Projects-and-Stuff/Chameleon/README.md

# Chameleon #
#### A colorful RBG LED drink coaster with capacitive sensing ####

---

*File Structure*

* ./Firmware/ --> Firmware for the project (Written in C Utilizing AVR Studio 5 and AVRGCC)
* ./Hardware/ --> Kicad Project for Chameleon
* ./GerberOutput/ --> The latest Gerber Files for manufacture
* ./Notes/ --> Project Notes, BOM, and Research

---

Additional information, research, and notes can be found at http://www.projectsandstuff.com, or email us at support@projectsandstuff.com

Let us know if you fork and make improvements. We'd be glad to consider merges that improve this project.

---

Updates can be found in the Project Log, in the Notes folder

---

CURRENT AUTHORS:

> [Jack Linke](http://www.jacklinke.com)
jacklinke@gmail.com
