Projects-and-Stuff/Chameleon/Case/Case.png

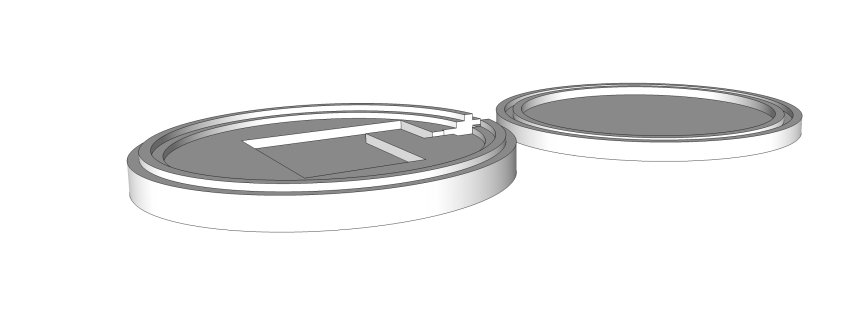
Case/Case.png
