Projects-and-Stuff/Chameleon/Notes/Chameleon BOM.xlsx

Sheet: Electronics
Bill of Materials - Chameleon Drink Coasters - Electronics |  |  |  |  |  |  |  |  |  |  | # of boards goal: | 500
Projects and Stuff LLC - http://www.projectsandstuff.com
Total BOM Parts Cost: | $4540.73 | Per Board Cost: | $9.08
Description | Mfg Part # | Package | KiCad Footprint | Default Supplier | Supplier On Hand | Qty per board | Total Qty Needed | Price per part at Qty | Price Per Board | Total Price | Notes | Part References
Capacitor Ceramic 1nF | CL10B102KB8SFNC | 0603 | GOOD | DigiKey | 80889 | 11 | 5500 | $0.00339 | $0.04 | $18.64 | Filtering for LEDs
Capacitor Ceramic 4.7nF 50V 10% | CL10B472KB8SFNC | 0603 | GOOD | DigiKey | 8836 | 2 | 1000 | $0.00618 | $0.01 | $6.18 | Used for QMatrix RY line capacitors and USB Shield Termination
Capacitor Ceramic 0.1uF 16V 10% | CL10B104KO8NNNC | 0603 | GOOD | DigiKey | 3312000 | 9 | 4500 | $0.00359 | $0.03 | $16.16 | Used for Power Input/Output filtering and Decoupling
Capacitor Ceramic 1uF 6.3V X5R | CL10B105KQ8NNNC | 0603 | GOOD | DigiKey | 408144 | 1 | 500 | $0.01310 | $0.01 | $6.55
Capacitor Ceramic 10uF 6.3V X5R | CL10A106MQ8NNNC | 0603 | GOOD | Digikey | 167415 | 3 | 1500 | $0.04650 | $0.14 | $69.75 | Input Capacitor used with Boost Regulator
Capacitor Ceramic 47uF 6.3V 20% | GRM31CR60J476ME19L | 1206 | GOOD | Digikey | 151601 | 1 | 500 | $0.19846 | $0.20 | $99.23 | Output Capacitor used with Boost Regulator
Resistor 120Ω 1/10W 5% | RC1608J121CS | 0603 | GOOD | Digikey | 9886 | 5 | 2500 | $0.00174 | $0.01 | $4.35 | Current limiting resistors for White LEDs
Resistor 1kΩ 1/10W 5% | RC0603JR-071KL | 0603 | GOOD | DigiKey | 38481 | 2 | 1000 | $0.00207 | $0.00414 | $2.07 | Used for QMatrix X&Y line resistors
Resistor 4kΩ | RC1608J392CS | 0603 | GOOD | DigiKey | 9400 | 1 | 500 | $0.00274 | $0.00274 | $1.37 | Provides Current Bias for the As1121
Resistor 10kΩ 1/10W 5% | RC1608J103CS | 0603 | GOOD | DigiKey | 3129 | 18 | 9000 | $0.00201 | $0.04 | $18.09 | Pull-up/down resistors
Resistor 100KΩ 1/10W 5% | RC0603JR-07100KL | 0603 | GOOD | DigiKey | 744323 | 2 | 1000 | $0.00207 | $0.00414 | $2.07
Resistor 300KΩ 1/10W 5% | RC0603JR-07300KL | 0603 | GOOD | DigiKey | 8889 | 1 | 500 | $0.00294 | $0.00294 | $1.47
Resistor 470KΩ 1/10W 5% | RC1608J474CS | 0603 | GOOD | DigiKey | 10000 | 1 | 500 | $0.00274 | $0.00274 | $1.37 | Used for QMatrix RY line resistors
Resistor 1.05MΩ 1/10W 1% | RC1608F1054CS | 0603 | GOOD | DigiKey | 9475 | 1 | 500 | $0.00206 | $0.00206 | $1.03 | Part of USB Shield Termination
Inductor 10uH 340mA 10% | LB3218T100K | 1207 | GOOD | DigiKey | 19931 | 1 | 500 | $0.08526 | $0.09 | $42.63 | Input Filtering for uC Power
Inductor 33uH 10% | LB3218T330K | 1207 | GOOD | DigiKey | 3051 | 1 | 500 | $0.08526 | $0.09 | $42.63 | Used with Boost Regulator Input
Ferrite Bead | BK0603HS330-T | 0603 | GOOD | Digikey | 22721 | 1 | 500 | $0.04554 | $0.05 | $22.77 | Analog Input filtering for uC
PLCC-6 RGB LED |  | 5.0mm x 5.0mm | G | Alibaba |  | 5 | 2500 | $0.03300 | $0.17 | $82.50 | LED Lighting
LED White |  | 0603 | G | AliExpress |  | 5 | 2500 | $0.03000 | $0.15 | $75.00 | White LED Lighting
LED Red Diffused | LS L29K-G1J2-1-Z | 0603 | GOOD | DigiKey | 63971 | 1 | 500 | $0.09140 | $0.09 | $45.70 | Power/Status Indicator
Diode Schottky 10V 0.57A | ZLLS410TA | SOT-23-3 | GOOD | Digikey | 34988 | 2 | 1000 | $0.12328 | $0.25 | $123.28 | Used with Boost Regulator and Latching Power Block
MOSFET N & P Pair | SI3588DV-T1-E3 | 6-TSOP | GOOD | Mouser | 3000 | 1 | 500 | $0.55000 | $0.55 | $275.00 | Used in Latching Power Block
Switch Tactile SPST-NO 0.05A 15V | TL3315NF160Q | 4.5mm x 4.5mm | GOOD | DigiKey | 132026 | 1 | 500 | $0.14674 | $0.15 | $73.37 | AVR Reset Switch
Switch Tactile SPST-NO 0.05A 12V | TL1105JAF160Q | 7.20mm x 7.00mm | GOOD | Digikey | 17721 | 1 | 500 | $0.31540 | $0.32 | $157.70 | Mode Select Switch
Switch Tactile SPST-NO 0.05A 12V | TL1105SPF250Q | 6.00mm x 6.00mm | GOOD | DigiKey | 12672 | 1 | 500 | $0.21850 | $0.22 | $109.25 | Power Switch
Switch Cap Round White | 1RWHT |  | GOOD | Digikey | 11252 | 2 | 1000 | $0.14490 | $0.29 | $144.90 | Cap for Power and Mode Select Switch
IC AVR XMEGA Microcontroller | ATXMEGA16A4U-AU | 44-TQFP | GOOD | Digikey | 586 | 1 | 500 | $1.59840 | $1.60 | $799.20 | Microcontroller with USB
IC Boost Regulator 5V 0.2A | NCP1402SN50T1G | 5-TSOP | GOOD | Digikey | 25844 | 1 | 500 | $0.41200 | $0.41 | $206.00 | Also available at Newark, Farnell, Avnet, Verical, etc. Used for powering LEDs
IC LDO 3.3V 0.15A | TLV71333PDBVR | SOT-23-5 | GOOD | Digikey | 3261 | 1 | 500 | $0.13260 | $0.13 | $66.30 | Provides power for digital components and White LEDs
IC LED Driver RGBA | AS1121-BQFT | 32-TQFN (5x5) | GOOD | Digikey | 990 | 1 | 500 | $1.34714 | $1.35 | $673.57
Fuse PTC 500mA | MF-FSMF050X-2 | 0603 | GOOD | Digikey | 13969 | 1 | 500 | $0.21360 | $0.21 | $106.80 | Protects USB from drawing too much current
Battery (Li-Poly 3.7V 500mAh) | JHY-303450 | 50.5mm x 34.5 mm x 3.2mm |  | Shenzhen Puchuangyuan Technology Co. Ltd |  | 1 | 500 | $1.66000 | $1.66 | $830.00 | Nominal Voltage: 3.7V
Connector Receptical USB Micro B | ZX62WRD-B-5PC | USB - Micro B | GOOD | Digikey | 4925 | 1 | 500 | $0.83160 | $0.83 | $415.80 | Water resistant USB Connector for charging and data
 |  |  |  |  |  |  | 0 |  | $0.00 | $0.00
 |  |  |  |  |  |  | 0 |  | $0.00 | $0.00
 |  |  |  |  |  |  | 0 |  | $0.00 | $0.00
 |  |  |  |  |  |  | 0 |  | $0.00 | $0.00
 |  |  |  |  |  |  | 0 |  | $0.00 | $0.00
 |  |  |  |  |  |  | 0 |  | $0.00 | $0.00
 |  |  |  |  |  |  | 0 |  | $0.00 | $0.00
 |  |  |  |  |  |  | 0 |  | $0.00 | $0.00
 |  |  |  |  |  |  | 0 |  | $0.00 | $0.00
 |  |  |  |  |  |  | 0 |  | $0.00 | $0.00
 |  |  |  |  |  |  | 0 |  | $0.00 | $0.00
 |  |  |  |  |  |  | 0 |  | $0.00 | $0.00
 |  |  |  |  |  |  | 0 |  | $0.00 | $0.00
 |  |  |  |  |  |  | 0 |  | $0.00 | $0.00
 |  |  |  |  |  |  | 0 |  | $0.00 | $0.00
 |  |  |  |  |  |  | 0 |  | $0.00 | $0.00
 |  |  |  |  |  |  | 0 |  | $0.00 | $0.00
 |  |  |  |  |  |  | 0 |  | $0.00 | $0.00
 |  |  |  |  |  |  | 0 |  | $0.00 | $0.00
 |  |  |  |  |  |  | 0 |  | $0.00 | $0.00
 |  |  |  |  |  |  | 0 |  | $0.00 | $0.00
 |  |  |  |  |  |  | 0 |  | $0.00 | $0.00
 |  |  |  |  |  |  | 0 |  | $0.00 | $0.00
 |  |  |  |  |  |  | 0 |  | $0.00 | $0.00
 |  |  |  |  |  |  | 0 |  | $0.00 | $0.00
 |  |  |  |  |  |  | 0 |  | $0.00 | $0.00
 |  |  |  |  |  |  | 0 |  | $0.00 | $0.00
 |  |  |  |  |  |  | 0 |  | $0.00 | $0.00
 |  |  |  |  |  |  | 0 |  | $0.00 | $0.00
 |  |  |  |  |  |  | 0 |  | $0.00 | $0.00
 |  |  |  |  |  |  | 0 |  | $0.00 | $0.00
 |  |  |  |  |  |  | 0 |  | $0.00 | $0.00
 |  |  |  |  |  |  | 0 |  | $0.00 | $0.00
 |  |  |  |  |  |  | 0 |  | $0.00 | $0.00
 |  |  |  |  |  |  | 0 |  | $0.00 | $0.00
 |  |  |  |  |  |  | 0 |  | $0.00 | $0.00
 |  |  |  |  |  |  | 0 |  | $0.00 | $0.00
 |  |  |  |  |  |  | 0 |  | $0.00 | $0.00
 |  |  |  |  |  |  | 0 |  | $0.00 | $0.00
 |  |  |  |  |  |  | 0 |  | $0.00 | $0.00
 |  |  |  |  |  |  | 0 |  | $0.00 | $0.00
 |  |  |  |  |  |  | 0 |  | $0.00 | $0.00
 |  |  |  |  |  |  | 0 |  | $0.00 | $0.00
 |  |  |  |  |  |  | 0 |  | $0.00 | $0.00
 |  |  |  |  |  |  | 0 |  | $0.00 | $0.00
 |  |  |  |  |  |  | 0 |  | $0.00 | $0.00
 |  |  |  |  |  |  | 0 |  | $0.00 | $0.00
 |  |  |  |  |  |  | 0 |  | $0.00 | $0.00
 |  |  |  |  |  |  | 0 |  | $0.00 | $0.00
 |  |  |  |  |  |  | 0 |  | $0.00 | $0.00
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
 |  |  |  |  |  |  | 0 |  | $0.00 | $0.00
 |  |  |  |  |  |  | 0 |  | $0.00 | $0.00
 |  |  |  |  |  |  | 0 |  | $0.00 | $0.00
 |  |  |  |  |  |  | 0 |  | $0.00 | $0.00
 |  |  |  |  |  |  | 0 |  | $0.00 | $0.00
 |  |  |  |  |  |  | 0 |  | $0.00 | $0.00
 |  |  |  |  |  |  | 0 |  | $0.00 | $0.00
 |  |  |  |  |  |  | 0 |  | $0.00 | $0.00
 |  |  |  |  |  |  | 0 |  | $0.00 | $0.00
 |  |  |  |  |  |  | 0 |  | $0.00 | $0.00
 |  |  |  |  |  |  | 0 |  | $0.00 | $0.00
 |  |  |  |  |  |  | 0 |  | $0.00 | $0.00
 |  |  |  |  |  |  | 0 |  | $0.00 | $0.00
 |  |  |  |  |  |  | 0 |  | $0.00 | $0.00
 |  |  |  |  |  |  | 0 |  | $0.00 | $0.00
 |  |  |  |  |  |  | 0 |  | $0.00 | $0.00
 |  |  |  |  |  |  | 0 |  | $0.00 | $0.00
 |  |  |  |  |  |  | 0 |  | $0.00 | $0.00
 |  |  |  |  |  |  | 0 |  | $0.00 | $0.00
 |  |  |  |  |  |  | 0 |  | $0.00 | $0.00
 |  |  |  |  |  |  | 0 |  | $0.00 | $0.00
 |  |  |  |  |  |  | 0 |  | $0.00 | $0.00

Sheet: Other
Bill of Materials - Chameleon Drink Coasters - Other |  |  |  |  |  |  |  | # of boards goal: | 1000
Projects and Stuff LLC - http://www.projectsandstuff.com
Total BOM Parts Cost: | $330.00
Description | Mfg Part # | Default Supplier | Supplier On Hand | Qty per board | Total Qty Needed | Price per part at Qty | Total Price | Notes | Part References
Indestructo Mailers | White or Kraft (http://www.uline.com/Grp_435/Indestructo-Mailers) | ULINE |  | 1 | 1000 | $0.24000 | $240.00 | (Similar also available at http://www.packagingsupplies.com/White_Corrugated_Boxes__Mailers.html - they're cheaper, but may not be enough on hand)
Plastic Case |  |  |  |  | 0 |  | $0.00
Foam Insert (D: 3.5" with battery cut-out) |  | Xingweicheng |  | 1 | 1000 | $0.09000 | $90.00
 |  |  |  |  | 0 |  | $0.00
 |  |  |  |  | 0 |  | $0.00
 |  |  |  |  | 0 |  | $0.00
 |  |  |  |  | 0 |  | $0.00
 |  |  |  |  | 0 |  | $0.00
 |  |  |  |  | 0 |  | $0.00
 |  |  |  |  | 0 |  | $0.00
 |  |  |  |  | 0 |  | $0.00
 |  |  |  |  | 0 |  | $0.00
 |  |  |  |  | 0 |  | $0.00
 |  |  |  |  | 0 |  | $0.00
 |  |  |  |  | 0 |  | $0.00
 |  |  |  |  | 0 |  | $0.00
 |  |  |  |  | 0 |  | $0.00
 |  |  |  |  | 0 |  | $0.00
 |  |  |  |  | 0 |  | $0.00
 |  |  |  |  | 0 |  | $0.00
 |  |  |  |  | 0 |  | $0.00
 |  |  |  |  | 0 |  | $0.00
 |  |  |  |  | 0 |  | $0.00
 |  |  |  |  | 0 |  | $0.00
 |  |  |  |  | 0 |  | $0.00
 |  |  |  |  | 0 |  | $0.00
 |  |  |  |  | 0 |  | $0.00
 |  |  |  |  | 0 |  | $0.00
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
 |  |  |  |  | 0 |  | $0.00
 |  |  |  |  | 0 |  | $0.00
 |  |  |  |  | 0 |  | $0.00
 |  |  |  |  | 0 |  | $0.00
 |  |  |  |  | 0 |  | $0.00
 |  |  |  |  | 0 |  | $0.00
 |  |  |  |  | 0 |  | $0.00
 |  |  |  |  | 0 |  | $0.00
 |  |  |  |  | 0 |  | $0.00
 |  |  |  |  | 0 |  | $0.00
 |  |  |  |  | 0 |  | $0.00
 |  |  |  |  | 0 |  | $0.00
 |  |  |  |  | 0 |  | $0.00
 |  |  |  |  | 0 |  | $0.00
 |  |  |  |  | 0 |  | $0.00
 |  |  |  |  | 0 |  | $0.00
