Projects-and-Stuff/Chameleon/Case/Case.stl

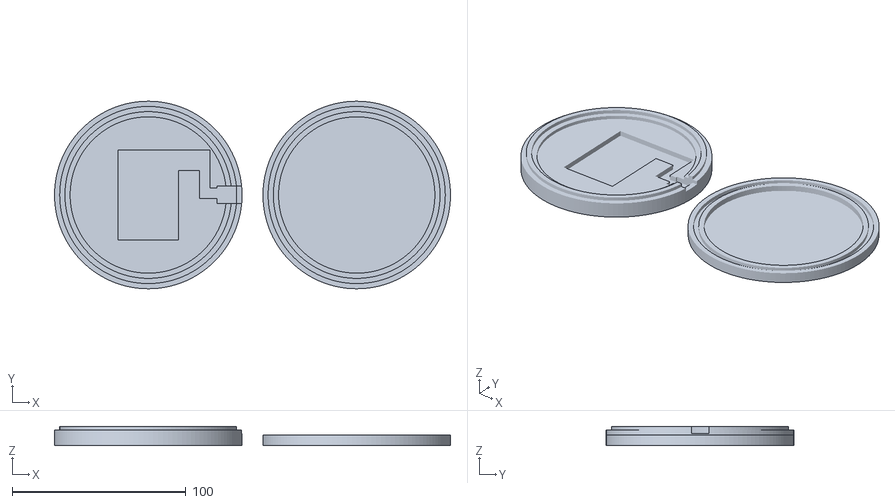
[picture p2: CAD file, 2012-12-21]
Case/Case.stl
228.0 x 108.0 x 11.0
