Projects-and-Stuff/Chameleon/(list of files, cad)

Other CAD files:
Case/Case_v (rebuilt).stl
Case/Case.skp
