Projects-and-Stuff/Chameleon/Notes/Chameleon Tutorial.docx

Projects and Stuff

Chameleon

Tutorial

# Overview and Objectives

# Assemble

## Part List

## Tools Required

## Constructing it

# Operate

# Mod

# Buy

# Discuss

Glossary
