Projects-and-Stuff/Chameleon/Hardware/Schematic.pdf

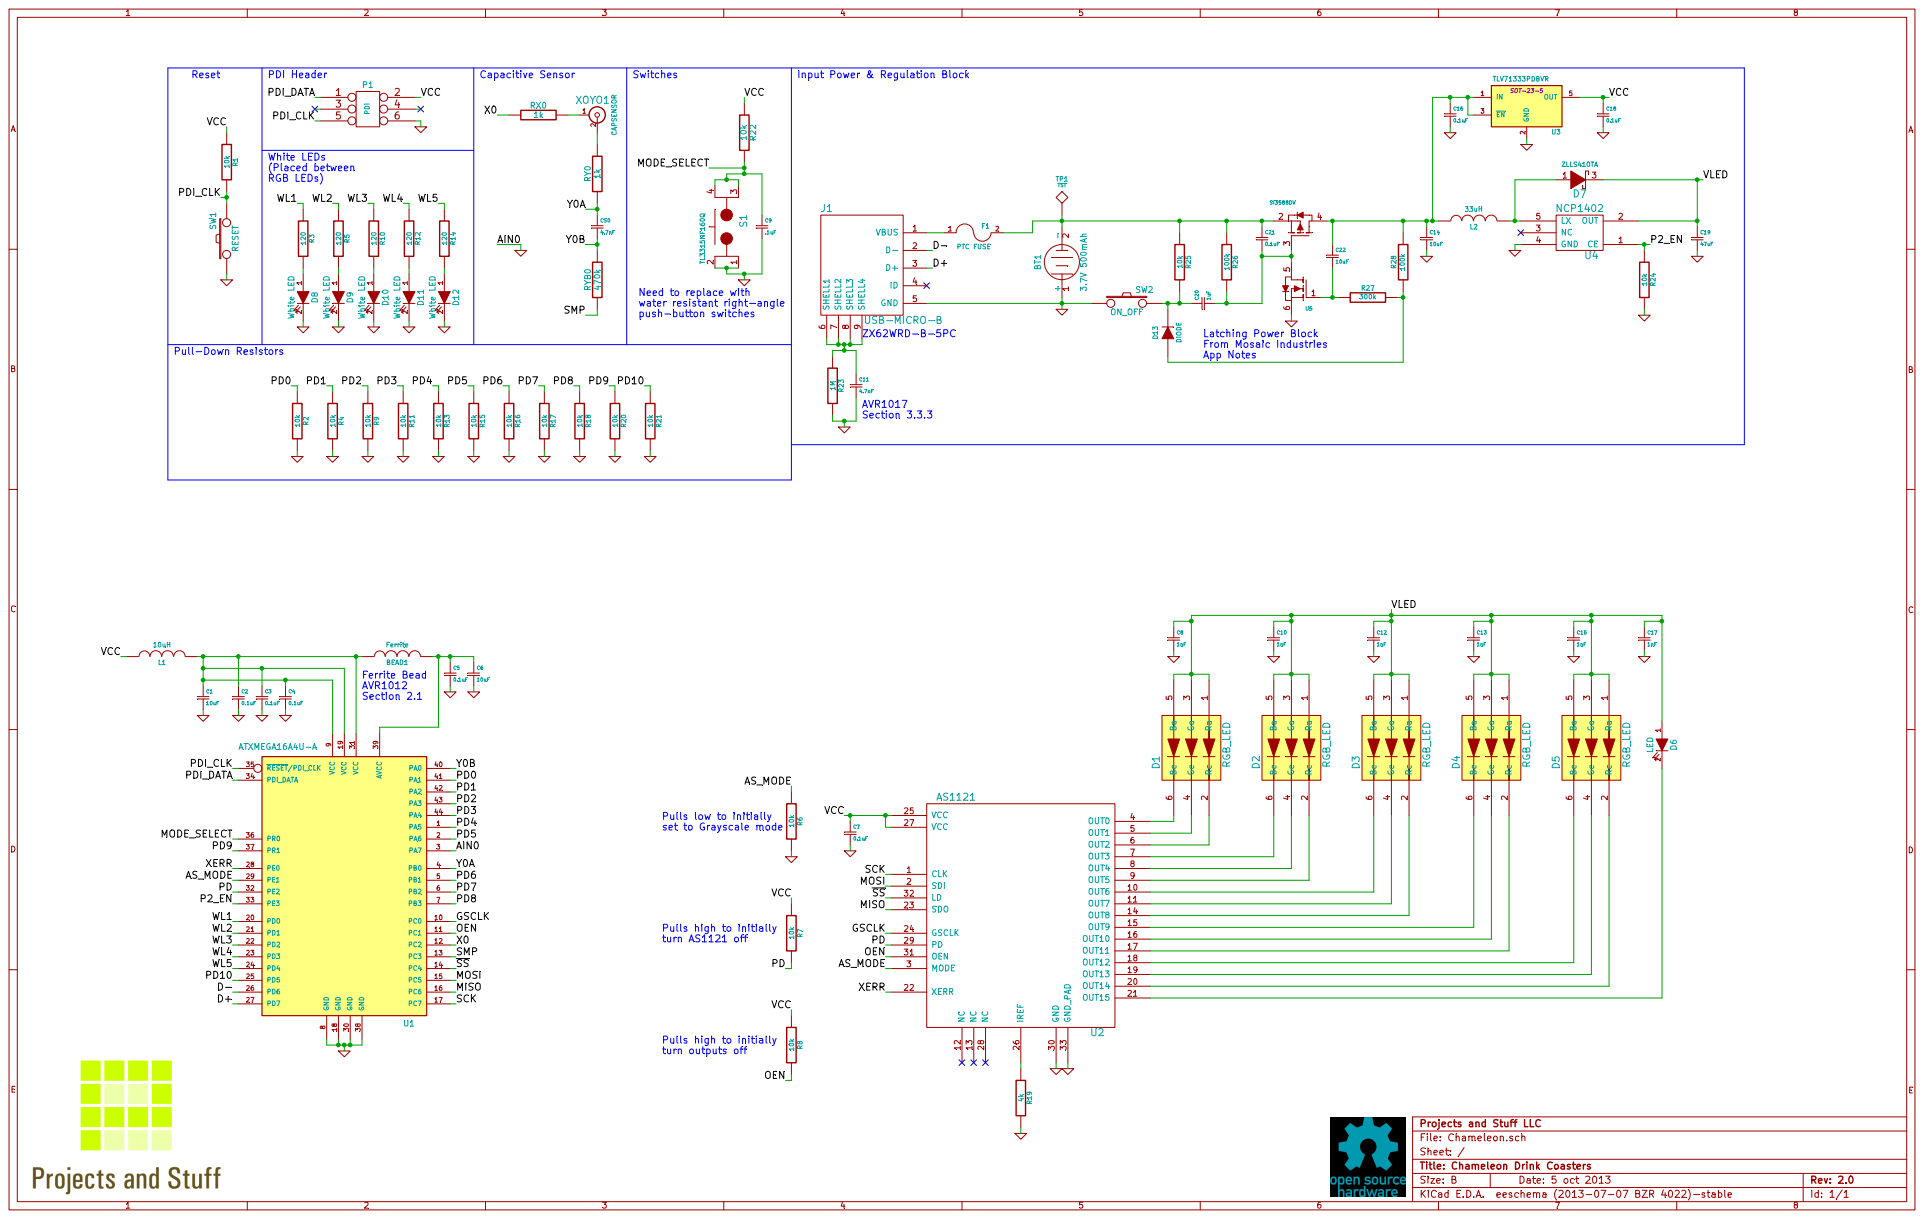
[picture p3: page 1]
