Projects-and-Stuff/Chameleon/Hardware/Back.pdf

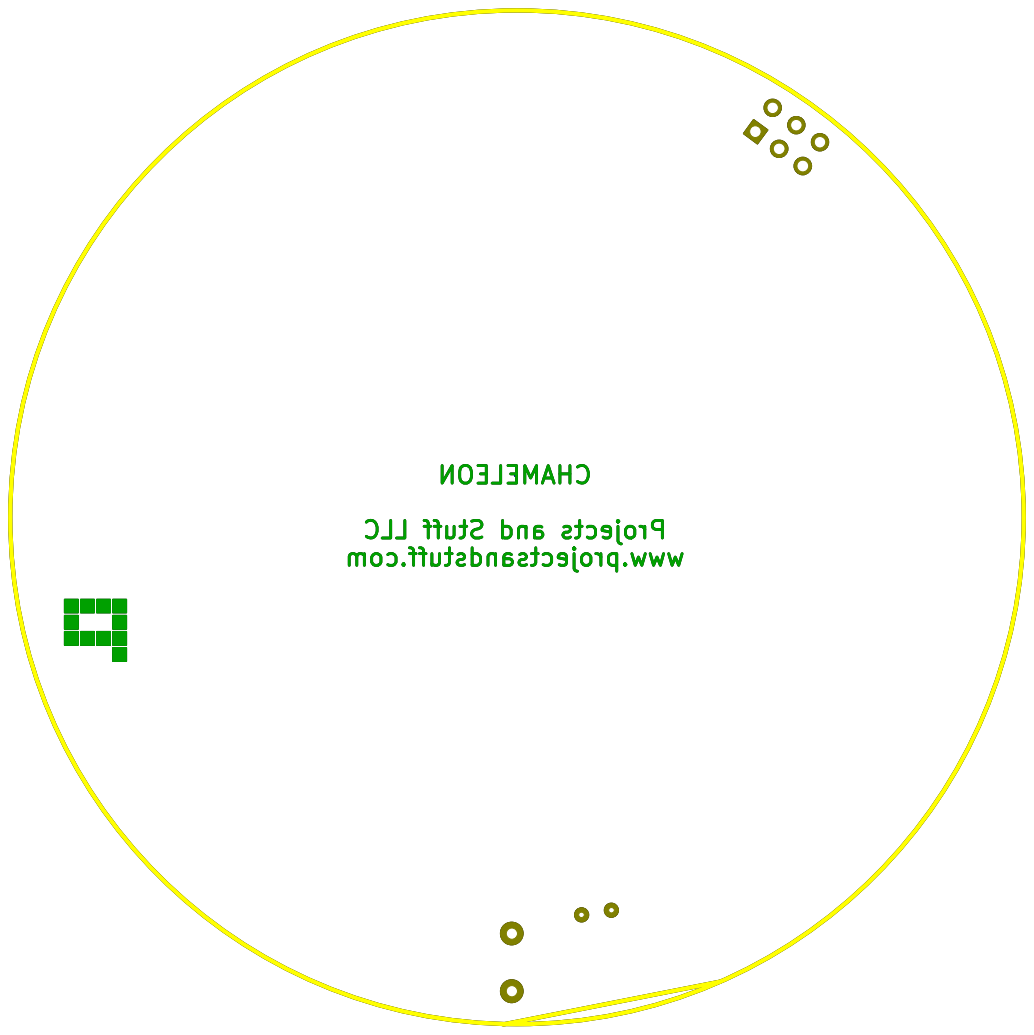
[picture p4: page 1]
