Projects-and-Stuff/Chameleon/Hardware/Front.pdf

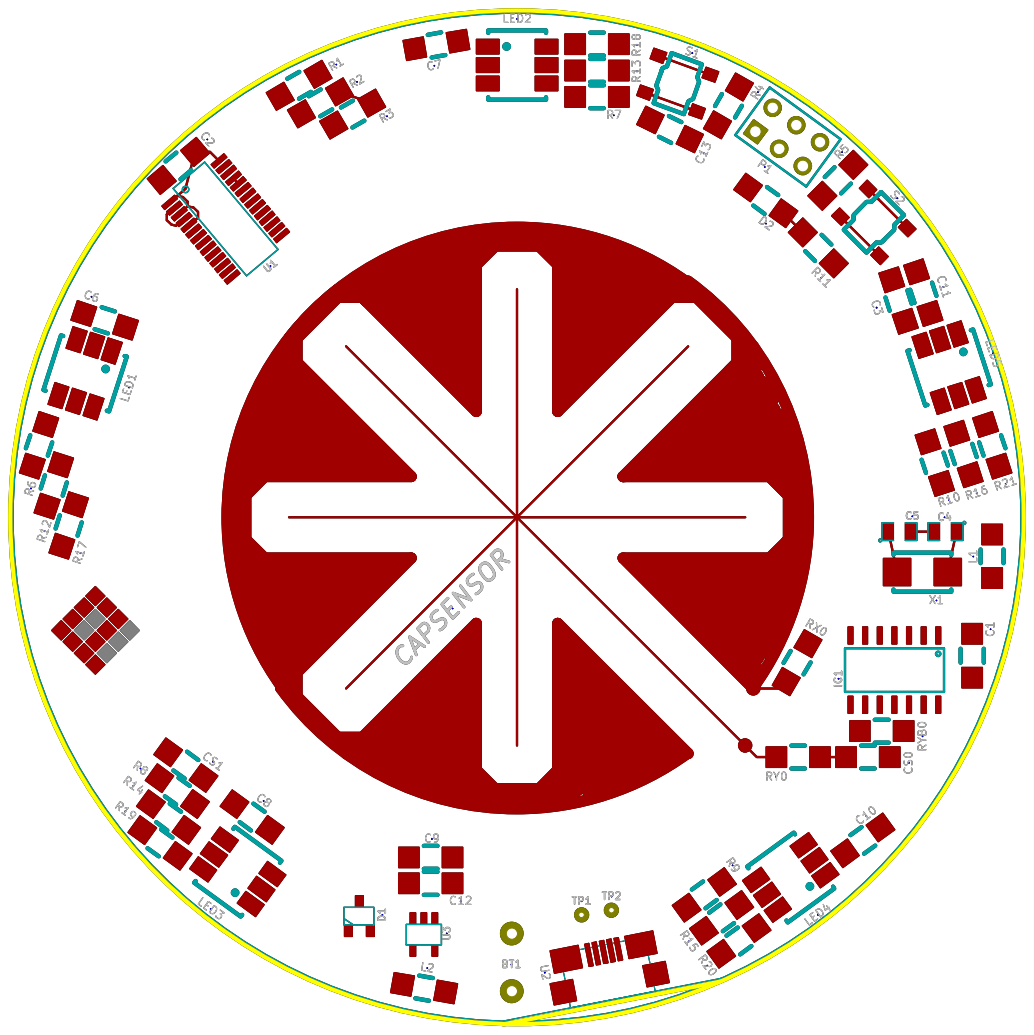
[picture p5: page 1]
