Projects-and-Stuff/Chameleon/(list of files, drawings)

Other design files:
Hardware/Chameleon.dsn
