Projects-and-Stuff/Chameleon/Hardware/Chameleon.kicad_pcb

## KiCad design Hardware/Chameleon.kicad_pcb (2013-11-11)

Schematic: Chameleon.sch, Chameleon Drink Coasters

Parts:
BEAD1: Ferrite
BT1: 3.7V 500mAh
C1, C6, C22: 10uF
C2, C3, C4, C5, C7, C16, C18, C21: 0.1uF
C8, C10, C12, C13, C15, C17: 1nF
C9: .1uF
C11: 4.7nF
C14: 10uF
C19: 47uF
C20: 1uF
CS0: 4.7nF
D1, D2, D3, D4, D5: RGB_LED
D6: LED
D7, D13: ZLLS410TA
D8, D9, D10, D11, D12: White LED
F1: PTC FUSE
IC1: ATXMEGA16A4U-A-MODIFIED; VQFN44
J1: USB-MICRO-B
L1: 10uH
L2: 33uH
P1: PDI
R1, R2, R4, R6, R7, R8, R9, R11, R13, R15, R16, R17, R18, R20, R21, R24, R25: 10k
R3, R5, R10, R12, R14: 120
R19: 4k
R22: 10k
R23: 1M
R26, R28: 100k
R27: 300k
RX0: 1k
RY0: 1k
RYB0: 470k
SW1: TL1105JAF160Q
SW2: TL1105SPF250Q
SW3: TL3315NF160Q
U2: AS1121
U3: TLV71333PDBVR; SOT-23-5
U4: NCP1402
U5: SI3588DV
XOYO1: CAPSENSOR

Connections:
/AS_MODE: IC1.29, R6.1, U2.3 (MODE)
/D+: IC1.27, J1.3 (D+)
/D-: IC1.26, J1.2 (D-)
/GSCLK: IC1.10, U2.24 (GSCLK)
/MISO: IC1.16, U2.23 (SDO)
/MODE_SELECT: C9.1, IC1.36, R22.2, SW1.2
/MOSI: IC1.15, U2.2 (SDI)
/OEN: IC1.11, R8.2, U2.31 (OEN)
/P2_EN: IC1.33, R24.1, U4.1 (CE)
/PD: IC1.32, R7.2, U2.29 (PD)
/PD0: IC1.41, R2.1
/PD1: IC1.42, R4.1
/PD2: IC1.43, R9.1
/PD3: IC1.44, R11.1
/PD4: IC1.1, R13.1
/PD5: IC1.2, R15.1
/PD6: IC1.5, R16.1
/PD7: IC1.6, R17.1
/PD8: IC1.7, R18.1
/PD9: IC1.37, R20.1
/PD10: IC1.25, R21.1
/PDI_CLK: IC1.35, P1.5, R1.2, SW3.3, SW3.4
/PDI_DATA: IC1.34, P1.1
/SCK: IC1.17, U2.1 (CLK)
/SHIELD: C11.1, J1.6 (SHELL1), J1.7 (SHELL2), J1.8 (SHELL3), J1.9 (SHELL4), R23.1
/SMP: IC1.13, RYB0.1
/VCC: C7.1, C18.1, L1.1, P1.2, R1.1, R7.1, R8.1, R22.1, U2.25 (VCC), U2.27 (VCC), U3.5 (OUT)
/VLED: C8.1, C10.1, C12.1, C13.1, C15.1, C17.1, C19.1, D1.1 (Ra), D1.3 (Ga), D1.5 (Ba), D2.1 (Ra), D2.3 (Ga), D2.5 (Ba), D3.1 (Ra), D3.3 (Ga), D3.5 (Ba), D4.1 (Ra), D4.3 (Ga), D4.5 (Ba), D5.1 (Ra), D5.3 (Ga), D5.5 (Ba), D6.1 (A), D7.2 (K), U4.2 (OUT)
/WL1: IC1.20, R3.1
/WL2: IC1.21, R5.1
/WL3: IC1.22, R10.1
/WL4: IC1.23, R12.1
/WL5: IC1.24, R14.1
/X0: IC1.12, RX0.1
/XERR: IC1.28, U2.22 (XERR)
/Y0A: CS0.1, IC1.4, RY0.1
/Y0B: CS0.2, IC1.40, RYB0.2
/~SS~: IC1.14, U2.32 (LD)
GND: BT1.1 (+), C1.2, C2.2, C3.2, C4.2, C5.2, C6.2, C7.2, C8.2, C9.2, C10.2, C11.2, C12.2, C13.2, C14.2, C15.2, C16.2, C17.2, C18.2, C19.2, D8.2 (K), D9.2 (K), D10.2 (K), D11.2 (K), D12.2 (K), IC1.3, IC1.8, IC1.18, IC1.30, IC1.38, IC1.45, J1.5 (GND), P1.6, R2.2, R4.2, R6.2, R9.2, R11.2, R13.2, R15.2, R16.2, R17.2, R18.2, R19.2, R20.2, R21.2, R23.2, R24.2, SW1.1, SW2.1, SW3.1, SW3.2, U2.30 (GND), U2.33 (GND_PAD), U3.2 (GND), U4.4 (GND), U5.6
unnamed: BEAD1.1, C1.1, C2.1, C3.1, C4.1, IC1.9, IC1.19, IC1.31, L1.2
unnamed: D5.2 (Rc), U2.20 (OUT14)
unnamed: D6.2 (K), U2.21 (OUT15)
unnamed: R19.1, U2.26 (IREF)
unnamed: D5.4 (Gc), U2.19 (OUT13)
unnamed: D1.4 (Gc), U2.5 (OUT1)
unnamed: D1.6 (Bc), U2.4 (OUT0)
unnamed: D1.2 (Rc), U2.6 (OUT2)
unnamed: D2.6 (Bc), U2.7 (OUT3)
unnamed: D2.4 (Gc), U2.8 (OUT4)
unnamed: D2.2 (Rc), U2.9 (OUT5)
unnamed: D3.6 (Bc), U2.10 (OUT6)
unnamed: D3.4 (Gc), U2.11 (OUT7)
unnamed: D3.2 (Rc), U2.14 (OUT8)
unnamed: D4.6 (Bc), U2.15 (OUT9)
unnamed: D4.4 (Gc), U2.16 (OUT10)
unnamed: D4.2 (Rc), U2.17 (OUT11)
unnamed: D5.6 (Bc), U2.18 (OUT12)
unnamed: RY0.2, XOYO1.2
unnamed: RX0.2, XOYO1.1
unnamed: D13.1 (A), R27.2, R28.1
unnamed: BT1.2 (-), C21.1, F1.2, R25.1, R26.1, U5.2
unnamed: C20.2, C21.2, R26.2, U5.3, U5.5
unnamed: C20.1, D13.2 (K), R25.2, SW2.2
unnamed: C22.2, R27.1, U5.1
unnamed: D7.1 (A), L2.2, U4.5 (LX)
unnamed: BEAD1.2, C5.1, C6.1, IC1.39
unnamed: F1.1, J1.1 (VBUS)
unnamed: D10.1 (A), R10.2
unnamed: D8.1 (A), R3.2
unnamed: D9.1 (A), R5.2
unnamed: D11.1 (A), R12.2
unnamed: D12.1 (A), R14.2
unnamed: C14.1, C16.1, C22.1, L2.1, R28.2, U3.1 (IN), U3.3 (~EN~), U5.4

Notes on the sheet:
PDI Header
Input Power & Regulation Block
Capacitive Sensor
Need to replace with water resistant right-angle push-button switches
ZX62WRD-B-5PC
Mode Select Switch
Pulls high to initially turn AS1121 off
Pulls high to initially turn outputs off
Pulls low to initially set to Grayscale mode
Reset
AVR1017 Section 3.3.3
Ferrite Bead AVR1012 Section 2.1
White LEDs (Placed between RGB LEDs)
Pull-Down Resistors
Latching Power Block From Mosaic Industries App Notes

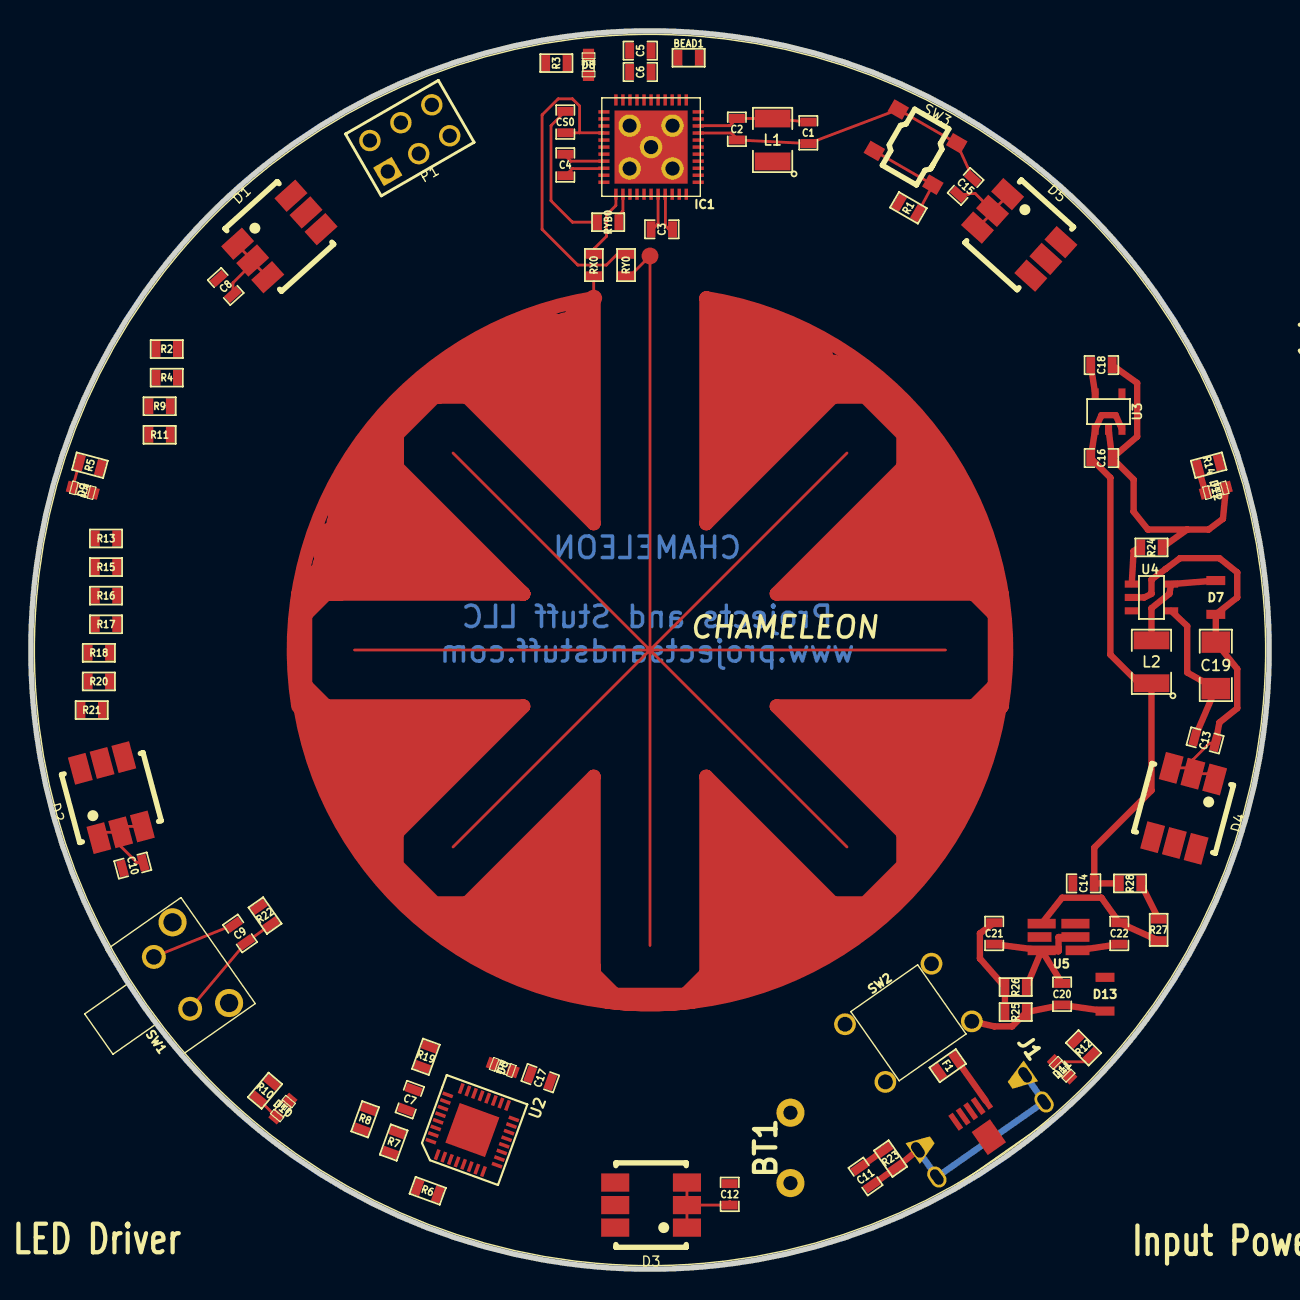
[picture p12: board Chameleon.kicad_pcb from above]

Board: 2 copper layers, 88.0 x 88.0 mm, 83 parts (0 on the bottom side), 73 nets.
