Projects-and-Stuff/Chameleon/Hardware/Chameleon.sch

## KiCad design Hardware/Chameleon.sch (2013-11-11, an earlier design)

Schematic: Chameleon.sch

Parts:
BT1: 3.7V 500mAh
C1, C2, C3, C6, C7, C8, C10, C11, C13: .1uF
C4, C5: 8pF
C9, C14: 10uF
C12: 47uF
CS0: 4.7nF
D1: DIODESCH_MOD
D2: LED
IC1: ATTINY44-SS; SO14
L1, L2: 33uH
LED1, LED2, LED3, LED4, LED5: RGB_LED
P1: CONN_3X2
R1, R2: 1.8k
R3, R22: 100
R4, R5: 10k
R6, R7, R8, R9, R10, R11: 330
R12, R13, R14, R15, R16, R17, R18, R19, R20, R21: 220
RX0: 1k
RY0: 1k
RYB0: 470k
S1, S2: TL3315NF160Q
TP1, TP2: TST
U1: PCA9685
U2: USBMICRO-B
U3: NCP1402
X1: CRYSTAL
XOYO1: CAPSENSOR

Notes on the sheet:
ISP Header
Input Power & Regulation Block
Crystal and Load Caps
Capacitive Sensor
