Projects-and-Stuff/Chameleon/Firmware/Touch_Test/Touch_Test/src/QTouch/qm_asm_avr.h

/* This source file is part of the ATMEL QTouch Library Release 4.3.1 */
/* This file is prepared for Doxygen automatic documentation generation. */
/*! \file *********************************************************************
 *
 * \brief  This file contains the QTouch Libary configuration options for
 *         AVR 8-bit QMatrix method Capacitive Touch acquisition.
 *
 * - Compiler:           IAR EWAVR and GNU GCC for AVR.
 * - Supported devices:  Atmel AVR 8-bit.
 * - Userguide:          QTouch Library User Guide - doc8207.pdf.
 * - Support email:      touch@atmel.com
 *
 * \author               Atmel Corporation: http://www.atmel.com \n
 *                       Support and FAQ: http://support.atmel.no/
 *
 ******************************************************************************/

/* Copyright (c) 2010 Atmel Corporation. All rights reserved.
 *
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
 * 3. The name of Atmel may not be used to endorse or promote products derived
 * from this software without specific prior written permission.
 *
 * 4. This software may only be redistributed and used in connection with an Atmel
 * AVR product.
 *
 * THIS SOFTWARE IS PROVIDED BY ATMEL "AS IS" AND ANY EXPRESS OR IMPLIED
 * WARRANTIES, INCLUDING, BUT NOT LIMITED TO, THE IMPLIED WARRANTIES OF
 * MERCHANTABILITY, FITNESS FOR A PARTICULAR PURPOSE AND NON-INFRINGEMENT ARE
 * EXPRESSLY AND SPECIFICALLY DISCLAIMED. IN NO EVENT SHALL ATMEL BE LIABLE FOR
 * ANY DIRECT, INDIRECT, INCIDENTAL, SPECIAL, EXEMPLARY, OR CONSEQUENTIAL DAMAGES
 * (INCLUDING, BUT NOT LIMITED TO, PROCUREMENT OF SUBSTITUTE GOODS OR SERVICES;
 * LOSS OF USE, DATA, OR PROFITS; OR BUSINESS INTERRUPTION) HOWEVER CAUSED AND
 * ON ANY THEORY OF LIABILITY, WHETHER IN CONTRACT, STRICT LIABILITY, OR TORT
 * (INCLUDING NEGLIGENCE OR OTHERWISE) ARISING IN ANY WAY OUT OF THE USE OF THIS
 * SOFTWARE, EVEN IF ADVISED OF THE POSSIBILITY OF SUCH DAMAGE
 *
 */

#ifndef _QM_ASM_AVR_H_
#define _QM_ASM_AVR_H_

#include "touch.h"

#ifdef _QMATRIX_

/**
  * If ATxmega device is used.
  * Possible values: comment/uncomment the lines
  */
#ifndef _ATXMEGA_
/*#define _ATXMEGA_*///! Uncomment this define for Xmega devices.
#endif


/**
  * Warning: Please donot edit below this line.
  */

//! In case of Xmega devices, the mask is used instead of the pin number.
#ifdef _ATXMEGA_
#define SMP_BIT (1 <<SMP_PIN)
#else
#define SMP_BIT SMP_PIN
#endif

/**
  * Setting dwell time in cycles, and an empirical discharge delay to give c.50%
  * duty cycle x pulses for the longer pulses. For the shorter ones, the spread
  * spectrum calculations mean that we can't get the pulse low time down short
  * enough for 50%.
  */
#if (QT_DELAY_CYCLES == 1u)

#define DWELL_TIME_CYCLES 1
#define DELAY_X_DISCHARGE 0

#elif (QT_DELAY_CYCLES == 2u)

#define DWELL_TIME_CYCLES 2
#define DELAY_X_DISCHARGE 0

#elif (QT_DELAY_CYCLES == 3u)

#define DWELL_TIME_CYCLES 3
#define DELAY_X_DISCHARGE 0

#elif (QT_DELAY_CYCLES == 4u)

#define DWELL_TIME_CYCLES 4
#define DELAY_X_DISCHARGE 0

#elif (QT_DELAY_CYCLES == 5u)

#define DWELL_TIME_CYCLES 5
#define DELAY_X_DISCHARGE 0


#elif (QT_DELAY_CYCLES == 10u)

#define DWELL_TIME_CYCLES 10
#define DELAY_X_DISCHARGE 10

#elif (QT_DELAY_CYCLES == 25u)

#define DWELL_TIME_CYCLES 25
#define DELAY_X_DISCHARGE 39

#elif (QT_DELAY_CYCLES == 50u)

#define DWELL_TIME_CYCLES 50
#define DELAY_X_DISCHARGE 103

#else
#error No burst dwell time specified or dwell time specified is wrong
#endif

#if (DWELL_TIME_CYCLES < 1u )
#error Dwell time must be at least 1 cycle.
#endif

/**
  * Set actual delay time in capacitive charge loop based on dwell time. The -1 is because
  * the following instruction in the charge transfer routine takes one cycle.
  */
#define DELAY_DWELL_TIME        (DWELL_TIME_CYCLES -1)
#define DELAY_PRECHARGE_TIME    (DWELL_TIME_CYCLES -1)
#define CLAMP_TO_DISCHARGE_TIME (DWELL_TIME_CYCLES -1)

//! Defines for IAR compiler and GNU compiler usage.
#if (defined(__IAR_SYSTEMS_ASM__) || defined(__ASSEMBLER__))

//! Defines specific for IAR compiler and usage.
#if defined(__IAR_SYSTEMS_ASM__)

#include <ioavr.h>
//! Registers used in the assembler files.
#define p_1 r16
#define p_2 r17
#define p_3 r18
#define p_4 r19
#define p_5 r20
#define p_6 r21
#define r_v r16
#define usr_1 r22
#define usr_2 r25
#define usr_3 r23

#define FILE_HEADER NAME qm_asm_iar
#define FILE_FOOTER END
#define FILE_SEGMENT RSEG CODE
#define GLOBAL_FUNCTION PUBLIC
//! defines specific for GNU compiler and usage.
#elif defined(__ASSEMBLER__)
#define __SFR_OFFSET 0
#include <avr/io.h>
//! Registers used in the assembler files.
#define p_1 r24
#define p_2 r22
#define p_3 r20
#define p_4 r18
#define p_5 r16
#define p_6 r14
#define r_v r24
#define usr_1 r23
#define usr_2 r25
#define usr_3 r21

#define FILE_HEADER
#define FILE_FOOTER
#define FILE_SEGMENT
#define GLOBAL_FUNCTION .global

#endif //! IAR or GCC assembler.

/**
  * Macro to build register writes for controlling ports. The intermediate
  * JOIN macro is required for correct expansion of the args.
  */
#define JOIN( x, y ) x ## y
#define JOIN1( A, B, C ) A ## B ## C

/**
  * Macro to build register writes for controlling ports. The intermediate
  * JOIN macro is required for correct expansion of the args.
  */
#define REG( REGISTER, SIDE ) JOIN( REGISTER, SIDE )
#define CONCAT( A,B, C ) JOIN1( A,B,C )
#define sreg_save r2
#define _00011001_	nop

#if (NUM_X_PORTS>=1)
#define _01101001_	brne _111_
#define _01101010_	brne _222_
#define _01101011_	brne _333_
#define _01101100_	brne _444_
#define _01101101_	brne _555_
#define _10001110_	rjmp .
#define _10100001_	_111_: dec r19
#define _10100010_	_222_: dec r19
#define _10100011_	_333_: dec r19
#define _10100100_	_444_: dec r19
#define _10100101_	_555_: dec r19
#define _11100001_	ldi r19, (CLAMP_TO_DISCHARGE_TIME/3)
#define _11100010_	ldi r19, (DELAY_PRECHARGE_TIME/3)
#define _11100011_	ldi r19, (DELAY_DWELL_TIME/3)
#define _11100100_	ldi r19, (DELAY_X_DISCHARGE/3)
#define _11100101_	ldi r19, (CLAMP_TO_DISCHARGE_TIME/3)
#endif //! NUM_X_PORTS==1.

#if (NUM_X_PORTS>=2)
#define _1001101001_	brne _666_
#define _1001101010_	brne _777_
#define _1001101011_	brne _888_
#define _1001101100_	brne _999_
#define _1001101101_	brne _AAA_
#define _1010001110_	rjmp .
#define _1010100001_	_666_: dec r19
#define _1010100010_	_777_: dec r19
#define _1010100011_	_888_: dec r19
#define _1010100100_	_999_: dec r19
#define _1010100101_	_AAA_: dec r19
#define _1011100001_	ldi r19, (CLAMP_TO_DISCHARGE_TIME/3)
#define _1011100010_	ldi r19, (DELAY_PRECHARGE_TIME/3)
#define _1011100011_	ldi r19, (DELAY_DWELL_TIME/3)
#define _1011100100_	ldi r19, (DELAY_X_DISCHARGE/3)
#define _1011100101_	ldi r19, (CLAMP_TO_DISCHARGE_TIME/3)
#endif //! NUM_X_PORTS==2.

#if (NUM_X_PORTS==3)
#define _1101101001_	brne _BBB_
#define _1101101010_	brne _CCC_
#define _1101101011_	brne _DDD_
#define _1101101100_	brne _EEE_
#define _1101101101_	brne _FFF_
#define _1110001110_	rjmp .
#define _1110100001_	_BBB_: dec r19
#define _1110100010_	_CCC_: dec r19
#define _1110100011_	_DDD_: dec r19
#define _1110100100_	_EEE_: dec r19
#define _1110100101_	_FFF_: dec r19
#define _1111100001_	ldi r19, (CLAMP_TO_DISCHARGE_TIME/3)
#define _1111100010_	ldi r19, (DELAY_PRECHARGE_TIME/3)
#define _1111100011_	ldi r19, (DELAY_DWELL_TIME/3)
#define _1111100100_	ldi r19, (DELAY_X_DISCHARGE/3)
#define _1111100101_	ldi r19, (CLAMP_TO_DISCHARGE_TIME/3)
#endif //! NUM_X_PORTS==3.

#endif //! IAR and GCC.
#endif //! Acquisition method: QMATRIX or QTOUCH.
#endif //! _QM_ASM_AVR_H_.
