Projects-and-Stuff/Chameleon/(commit log)

2012-05-06 Continued laying out schematics and updated Project Log
    [Chameleon.sch]
2012-05-06 Updated with PDF of current Schematic Image
    [Chameleon.sch]
2012-05-08 Heavily updated schematics and Project Log
    [Chameleon.sch]
2012-05-08 Added blank BOM sheet. Will update soon
    [Chameleon BOM.xlsx]
2012-05-12 Made several updates to BOM, Project Log, and Schematics
    [Chameleon BOM.xlsx, Chameleon.sch]
2012-05-12 Updated Schematics with Boost regulator and PCA9685
    [Chameleon.sch]
2012-05-12 Updated Schematics with USB connector, and updated BOM and Project Log
    [Chameleon BOM.xlsx, Chameleon.sch]
2012-05-13 Annotated Schematics and finalized BOM
    [Chameleon BOM.xlsx, Chameleon.sch]
2012-05-13 Began working on Board design
    [Chameleon.brd]
2012-05-13 Wow, almost 4am. Worked on PCB layout. Needs more work. Components too close together
    [Chameleon.brd, Chameleon.sch]
2012-05-16 Placing and routing today. Read Project Log for more detail
    [Chameleon.brd, Chameleon.dsn]
2012-05-16 Completed lots of placing, routing, and autorouting. Also updated Project Log
    [Chameleon.brd, Chameleon.dsn]
2012-05-17 Completed Prototype design. Exported Gerbers.
    [Chameleon.brd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]
2012-05-17 Updated BOM with additional sheet for non-electronic parts
    [Chameleon BOM.xlsx]
2012-05-19 Added initial firmware skeleton
    [Chameleon BOM_2.xlsx]
2012-06-07 Updated Project Log with notes on initial prototype
2012-08-06 Updated Project Log and initial working code for LEDs
2012-08-13 Corrected the majority of known issues in Schematics and PCB, and updated BOM and Project Log
    [Chameleon BOM.xlsx, Chameleon.brd, Chameleon.sch]
2012-08-16 Updated BOM, renamed CS1 to C14, Improved firmware slightly
    [Chameleon BOM.xlsx, Chameleon.brd, Chameleon.sch]
2012-08-26 Cleaned up schematics and added footprint column to BOM. Yet to be populated
    [Chameleon BOM.xlsx, Chameleon.sch]
2012-08-28 Added I2C series resistors, updated Project Log, added PDF version of Project Log
    [Chameleon BOM.xlsx, Chameleon.sch]
2012-08-28 Added series resistors to the PCB
    [Chameleon.brd]
2012-09-10 Updated schematics and Project Log with new resistor values, and added PDF BOM
    [Chameleon BOM.xlsx, Chameleon.sch]
2012-12-21 Added basic case prototype
    [Case.skp, Case.stl, Case_v (rebuilt).stl]
2012-12-21 Updated prototype case to better fit wiring and protect battery
    [Case.skp]
2012-12-31 Created a basic case for the project. Not quite perfect yet.
    [Case.skp]
2012-12-31 Routed board (with LEDs corrected) and updated Project Log
    [Chameleon.brd, Chameleon.dsn, Chameleon.sch]
2012-12-31 Including Gerber and drill files.
    [Chameleon-Back.gbl, Chameleon-Front.gtl, Chameleon-Mask_Front.gts, Chameleon-PCB_Edges.gbr, Chameleon-SilkS_Front.gto, Chameleon-SoldP_Front.gtp, Chameleon.drl]
2013-09-29 Began transitioning to updated Parts to improve function and increase capability.
    [Chameleon.sch]
2013-09-29 Made a number of notes in the schematics based on new knowledge and past mistakes.
    [Chameleon.sch]
2013-09-30 Made major updates to power management and control
    [Chameleon.sch]
2013-09-30 Updated version number
    [Chameleon.sch]
2013-09-30 Updated schematic PDF
2013-09-30 Updated PDI Header and Reset circuitry
    [Chameleon.sch]
2013-10-01 Began updating BOM with new parts and updated data.
    [Chameleon BOM.xlsx]
2013-10-01 Added input power to uC, modified pins, added white LEDs and SPST switch, and made other small changes.
    [Chameleon.sch]
2013-10-02 Updated BOM with current prices and mostly 0603 packages for discrete components.
    [Chameleon BOM.xlsx]
2013-10-04 Finalized (for now) the schematics and annotated components.
    [Chameleon.sch]
2013-10-04 Began placing components onto board
    [Chameleon BOM.xlsx]
2013-10-04 Including forgotten PCB files
    [Chameleon.kicad_pcb]
2013-10-05 Added latching power block
    [Chameleon.sch]
2013-10-06 Updated schematics with annotation
    [Chameleon.sch]
2013-10-06 Created netlist and imported components into PCB
    [Chameleon.kicad_pcb]
2013-10-06 Updated BOM with latching power components
    [Chameleon BOM.xlsx]
2013-10-20 Began grouping components
    [Chameleon.kicad_pcb, Chameleon.sch]
2013-11-08 Added VQFN44 and updated XMega chip in PCB
    [Chameleon.kicad_pcb]
2013-11-09 Updated XMega with Ground pin and placed several main components
    [Chameleon.kicad_pcb, Chameleon.sch]
2013-11-11 Placed all components, made important routes, and set keepouts for initial autoroute test run.
    [Chameleon.kicad_pcb, Chameleon.sch]
2013-11-11 After initial Autoroute attempt, made adjustments to component layout. Iterating again...
    [Chameleon.dsn, Chameleon.kicad_pcb]
